dronefpgabasedarchitecture-pizza/portapack/README.md

portapack
=========

Portable software-defined radio add-on for HackRF Jawbreaker
