dronefpgabasedarchitecture-pizza/portapack/portapack_hackrf/hardware/portapack_hackrf_one/portapack_hackrf_one.pdf

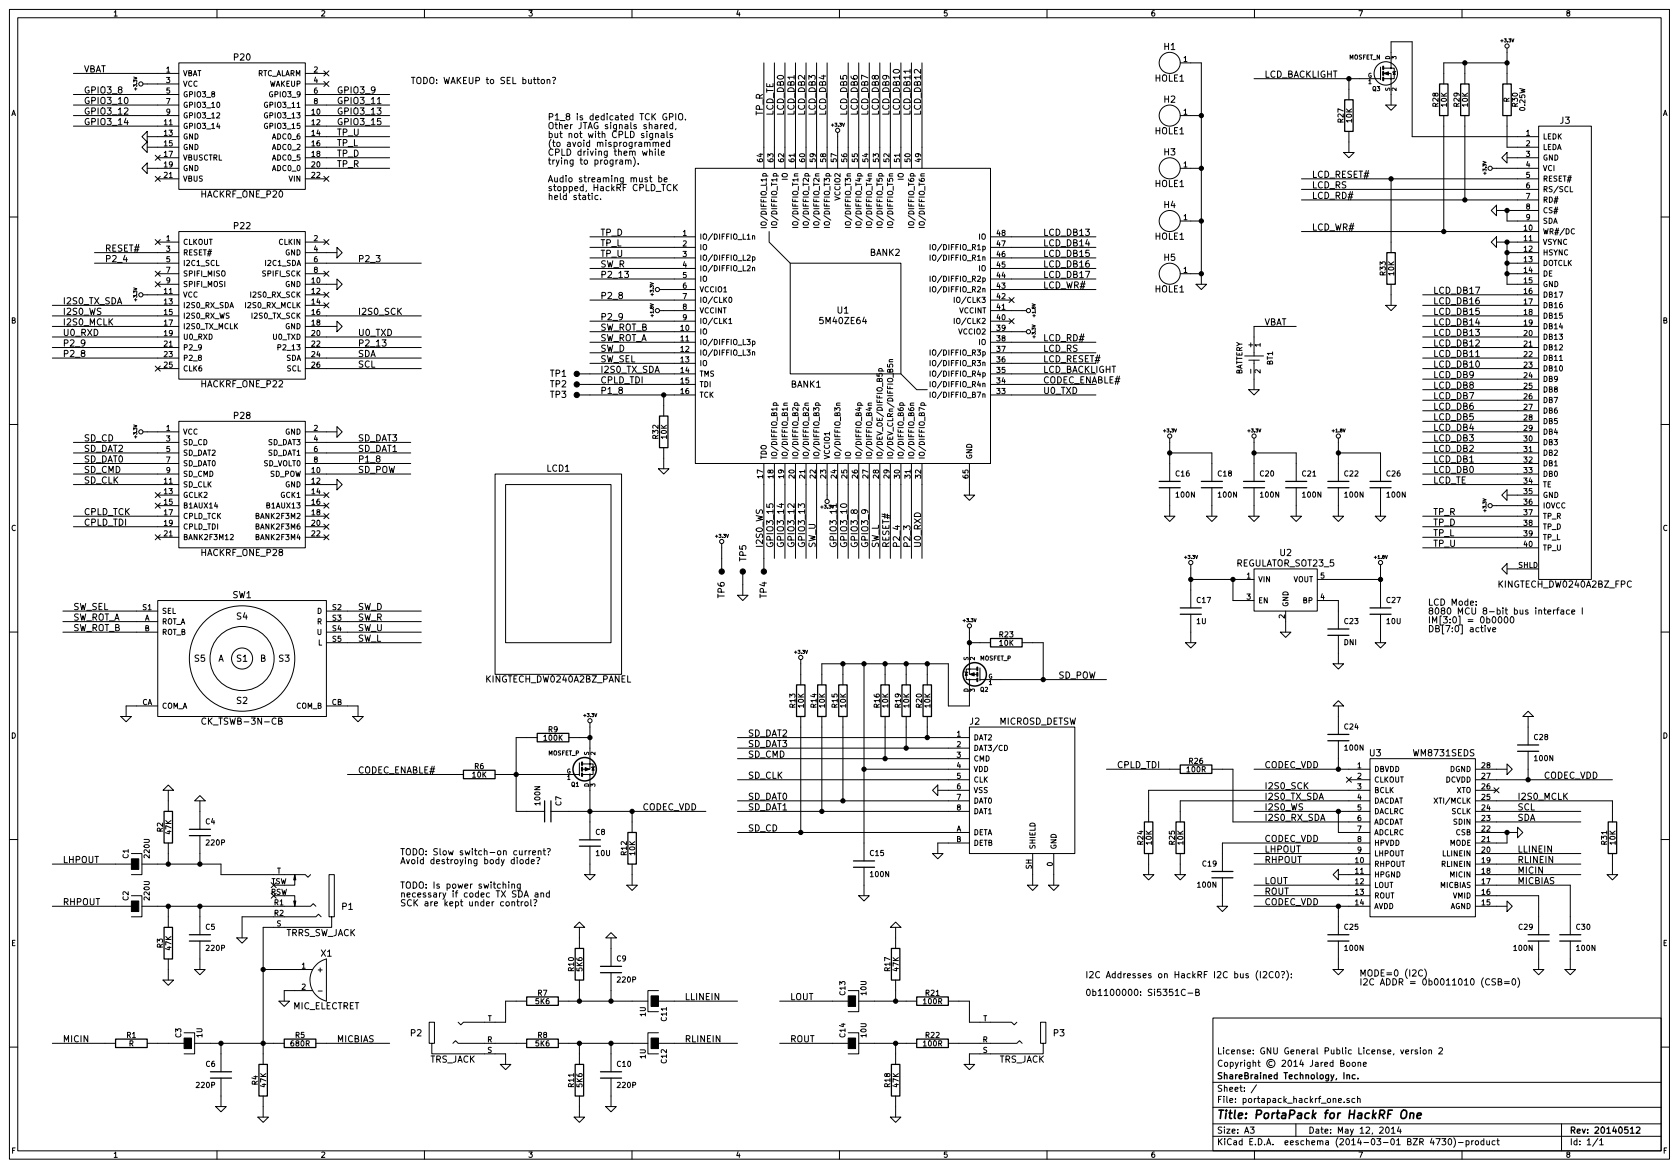
[picture p1: page 1]
