dronefpgabasedarchitecture-pizza/portapack/portapack_hackrf/hardware/portapack_hackrf_one/portapack_hackrf_one.kicad_pcb

## KiCad design portapack_hackrf/hardware/portapack_hackrf_one/portapack_hackrf_one.kicad_pcb (2014-05-29)

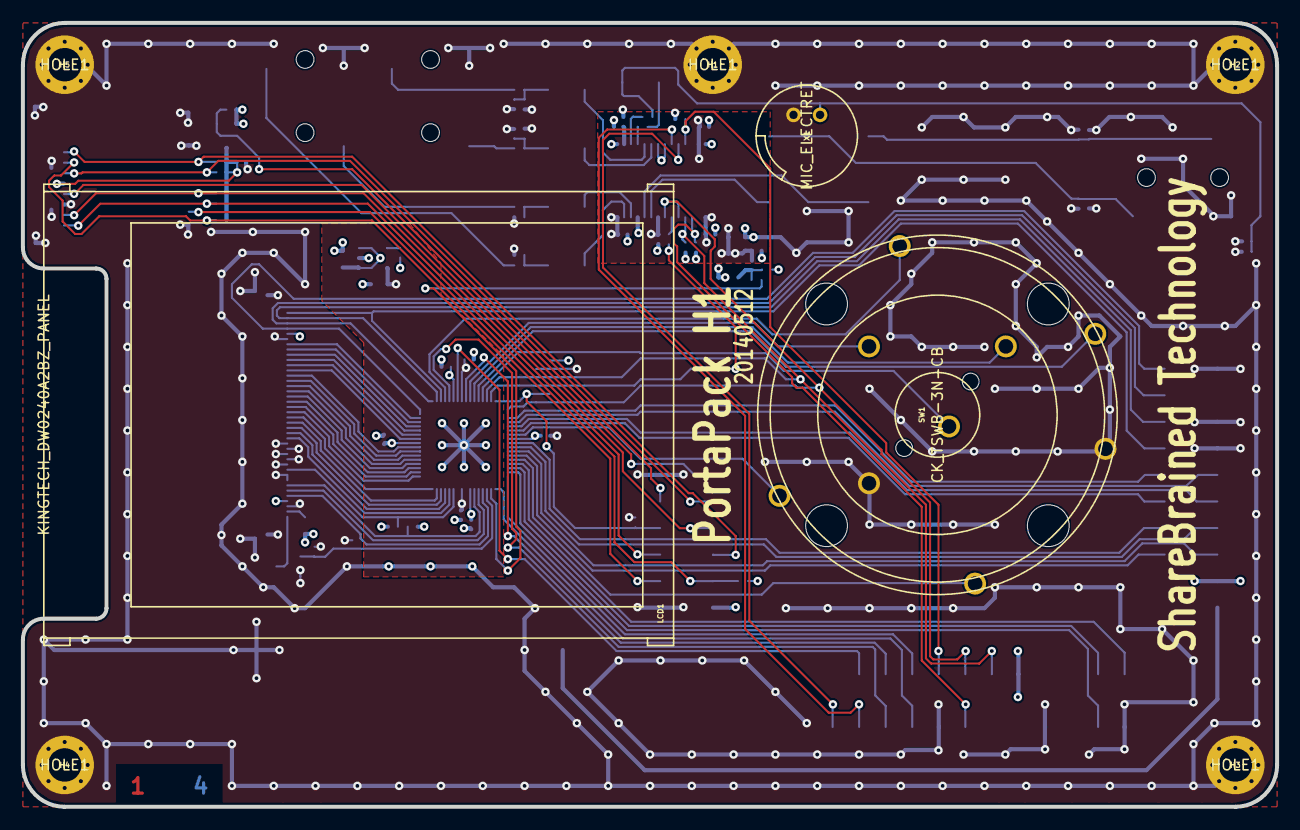
[picture p2: board portapack_hackrf_one.kicad_pcb from above]

Board: 4 copper layers, 120.0 x 75.0 mm, 92 parts (0 on the bottom side), 100 nets.

Parts:
BT1: BATTERY; MPD_BU2032SM-BT-G
C1, C2: 220U; IPC_CAPAE830X620N
C3, C11, C12: 1U; IPC_CAPAE430X540N
C4, C5, C6, C9, C10: 220P; IPC_CAPC1005X55N
C7, C15, C16, C18, C19, C20, C21, C22, C24, C25, C26, C28, C29, C30: 100N; IPC_CAPC1005X55N
C8, C27: 10U; IPC_CAPC1608X95N
C13, C14: 10U; IPC_CAPAE430X540N
C17: 1U; IPC_CAPC1608X95N
C23: DNI; IPC_CAPC1005X55N
H1, H2, H3, H4, H5: HOLE1; HOLE_3200UM_VIAS
J2: MICROSD_DETSW; ALPS_SCHA4B0400
J3: KINGTECH_DW0240A2BZ_FPC; MOLEX_54132-40XX_LR
LCD1: KINGTECH_DW0240A2BZ_PANEL
P1: TRRS_SW_JACK; CUI_SJ-43516-SMT
P2, P3: TRS_JACK; CUI_SJ-3524-SMT
P20: HACKRF_ONE_P20; HEADER_11X2_REV_SM_254
P22: HACKRF_ONE_P22; HEADER_13X2_REV_SM_254
P28: HACKRF_ONE_P28; HEADER_11X2_REV_SM_254
Q1, Q2: MOSFET_P; IPC_SOT95P240X110-3N
Q3: MOSFET_N; IPC_SOT95P230X110-3N
R1: R; IPC_RESC1005X40N
R2, R3, R4, R17, R18: 47K; IPC_RESC1005X40N
R5: 680R; IPC_RESC1005X40N
R6, R12, R13, R14, R15, R16, R19, R20, R23, R24, R25, R27, R28, R29, R31, R32, R33: 10K; IPC_RESC1005X40N
R7, R8, R10, R11: 5K6; IPC_RESC1005X40N
R9: 100K; IPC_RESC1005X40N
R21, R22, R26: 100R; IPC_RESC1005X40N
R30: R; IPC_RESC1608X55N
SW1: CK_TSWB-3N-CB; CK_TSWB-3N-CB222_LFS
TP1, TP2, TP3, TP4, TP5, TP6: TP; TP_1MM
U1: 5M40ZE64; IPC_QFP40P900X900X120-65N
U2: REGULATOR_SOT23_5; IPC_SOT95P280X110-5N
U3: WM8731SEDS; IPC_SOP65P780X200-28N
X1: MIC_ELECTRET; CUI_CMA-4544PF-W

Connections:
+1.8V: C22.1, C26.1, C27.1, U1.8, U1.41, U2.5
+3.3V: C16.1, C17.1, C18.1, C20.1, C21.1, J3.4, J3.36, P20.3, P22.11, P28.1, Q1.2, Q2.2, R9.1, R13.1, R23.1, R28.1, R29.1, R30.1, TP6.1, U1.6, U1.23, U1.39, U1.57, U2.1, U2.3
/CODEC_ENABLE#: R6.2, U1.34
/CODEC_VDD: C7.1, C8.1, C19.1, C24.2, C25.1, C28.2, Q1.3, R12.1, U3.1, U3.8, U3.14, U3.27
/CPLD_TDI: P28.19, R26.2, TP2.1, U1.15
/GPIO3_8: P20.5, U1.26
/GPIO3_9: P20.6, U1.27
/GPIO3_10: P20.7, U1.25
/GPIO3_11: P20.8, U1.24
/GPIO3_12: P20.9, U1.20
/GPIO3_13: P20.10, U1.21
/GPIO3_14: P20.11, U1.19
/GPIO3_15: P20.12, U1.18
/I2S0_MCLK: P22.17, R31.1, U3.25
/I2S0_RX_SDA: R26.1, U3.6
/I2S0_SCK: P22.16, R24.1, U3.3
/I2S0_TX_SDA: P22.13, R25.1, TP1.1, U1.14, U3.4
/I2S0_WS: P22.15, TP4.1, U1.17, U3.5, U3.7
/LCD_BACKLIGHT: Q3.1, R27.1, U1.35
/LCD_DB0: J3.33, U1.62
/LCD_DB1: J3.32, U1.61
/LCD_DB2: J3.31, U1.60
/LCD_DB3: J3.30, U1.59
/LCD_DB4: J3.29, U1.58
/LCD_DB5: J3.28, U1.56
/LCD_DB6: J3.27, U1.55
/LCD_DB7: J3.26, U1.54
/LCD_DB8: J3.25, U1.53
/LCD_DB9: J3.24, U1.52
/LCD_DB10: J3.23, U1.51
/LCD_DB11: J3.22, U1.50
/LCD_DB12: J3.21, U1.49
/LCD_DB13: J3.20, U1.48
/LCD_DB14: J3.19, U1.47
/LCD_DB15: J3.18, U1.46
/LCD_DB16: J3.17, U1.45
/LCD_DB17: J3.16, U1.44
/LCD_RD#: J3.7, R29.2, U1.38
/LCD_RESET#: J3.5, R33.1, U1.36
/LCD_RS: J3.6, U1.37
/LCD_TE: J3.34, U1.63
/LCD_WR#: J3.10, R28.2, U1.43
/LHPOUT: C1.1, U3.9
/LLINEIN: C11.1, U3.20
/LOUT: C13.1, U3.12
/MICBIAS: C30.1, R5.1, U3.17
/MICIN: R1.2, U3.18
/P1_8: P28.8, R32.1, TP3.1, U1.16
/P2_3: P22.6, U1.31
/P2_4: P22.5, U1.30
/P2_8: P22.23, U1.7
/P2_9: P22.21, U1.9
/P2_13: P22.22, U1.5
/RESET#: P22.3, U1.29
/RHPOUT: C2.1, U3.10
/RLINEIN: C12.1, U3.19
/ROUT: C14.1, U3.13
/SCL: P22.26, U3.24
/SDA: P22.24, U3.23
/SD_CD: J2.A, P28.3, R13.2
/SD_CLK: J2.5, P28.11
/SD_CMD: J2.3, P28.9, R16.2
/SD_DAT0: J2.7, P28.7, R15.2
/SD_DAT1: J2.8, P28.6, R14.2
/SD_DAT2: J2.1, P28.5, R20.2
/SD_DAT3: J2.2, P28.4, R19.2
/SD_POW: P28.10, Q2.1, R23.2
/SW_D: SW1.S2, U1.12
/SW_L: SW1.S5, U1.28
/SW_R: SW1.S3, U1.4
/SW_ROT_A: SW1.A, U1.11
/SW_ROT_B: SW1.B, U1.10
/SW_SEL: SW1.S1, U1.13
/SW_U: SW1.S4, U1.22
/TP_D: J3.38, P20.18, U1.1
/TP_L: J3.39, P20.16, U1.2
/TP_R: J3.37, P20.20, U1.64
/TP_U: J3.40, P20.14, U1.3
/U0_RXD: P22.19, U1.32
/U0_TXD: P22.20, U1.33
/VBAT: BT1.1, P20.1
GND: BT1.2, C4.1, C5.2, C6.2, C8.2, C9.1, C10.2, C15.2, C16.2, C17.2, C18.2, C19.2, C20.2, C21.2, C22.2, C23.2, C24.1, C25.2, C26.2, C27.2, C28.1, C29.2, C30.2, H1.1, H2.1, H3.1, H4.1, H5.1, J2.0, J2.6, J2.B, J2.SH, J3.3, J3.8, J3.9, J3.11, J3.12, J3.13, J3.14, J3.15, J3.35, J3.SHLD, P1.4, P2.1, P3.1, P20.13, P20.15, P20.19, P22.4, P22.10, P22.18, P28.2, P28.12, Q3.2, R2.1, R3.2, R4.2, R10.1, R11.2, R12.2, R17.1, R18.2, R24.2, R25.2, R27.2, R31.2, R32.2, R33.2, SW1.CA, SW1.CB, TP5.1, U1.65, U2.2, U3.11, U3.15, U3.21, U3.22, U3.28, X1.2
unnamed: C1.2, C4.2, P1.2, R2.2
unnamed: C2.2, C5.1, P1.3, R3.1
unnamed: C3.1, R1.1
unnamed: C3.2, C6.1, P1.1, R4.1, R5.2, X1.1
unnamed: C7.2, Q1.1, R6.1, R9.2
unnamed: C10.1, C12.2, R8.1, R11.1
unnamed: C9.2, C11.2, R7.1, R10.2
unnamed: C13.2, R17.2, R21.2
unnamed: C14.2, R18.1, R22.2
unnamed: C15.1, J2.4, Q2.3, R14.1, R15.1, R16.1, R19.1, R20.1
unnamed: C23.1, U2.4
unnamed: C29.1, U3.16
unnamed: J3.1, Q3.3
unnamed: J3.2, R30.2
unnamed: P2.2, R7.2
unnamed: P2.3, R8.2
unnamed: P3.2, R21.1
unnamed: P3.3, R22.1
