dronefpgabasedarchitecture-pizza/portapack/portapack_hackrf/hardware/portapack_jawbreaker/portapack_jawbreaker.kicad_pcb

## KiCad design portapack_hackrf/hardware/portapack_jawbreaker/portapack_jawbreaker.kicad_pcb (2014-01-01)

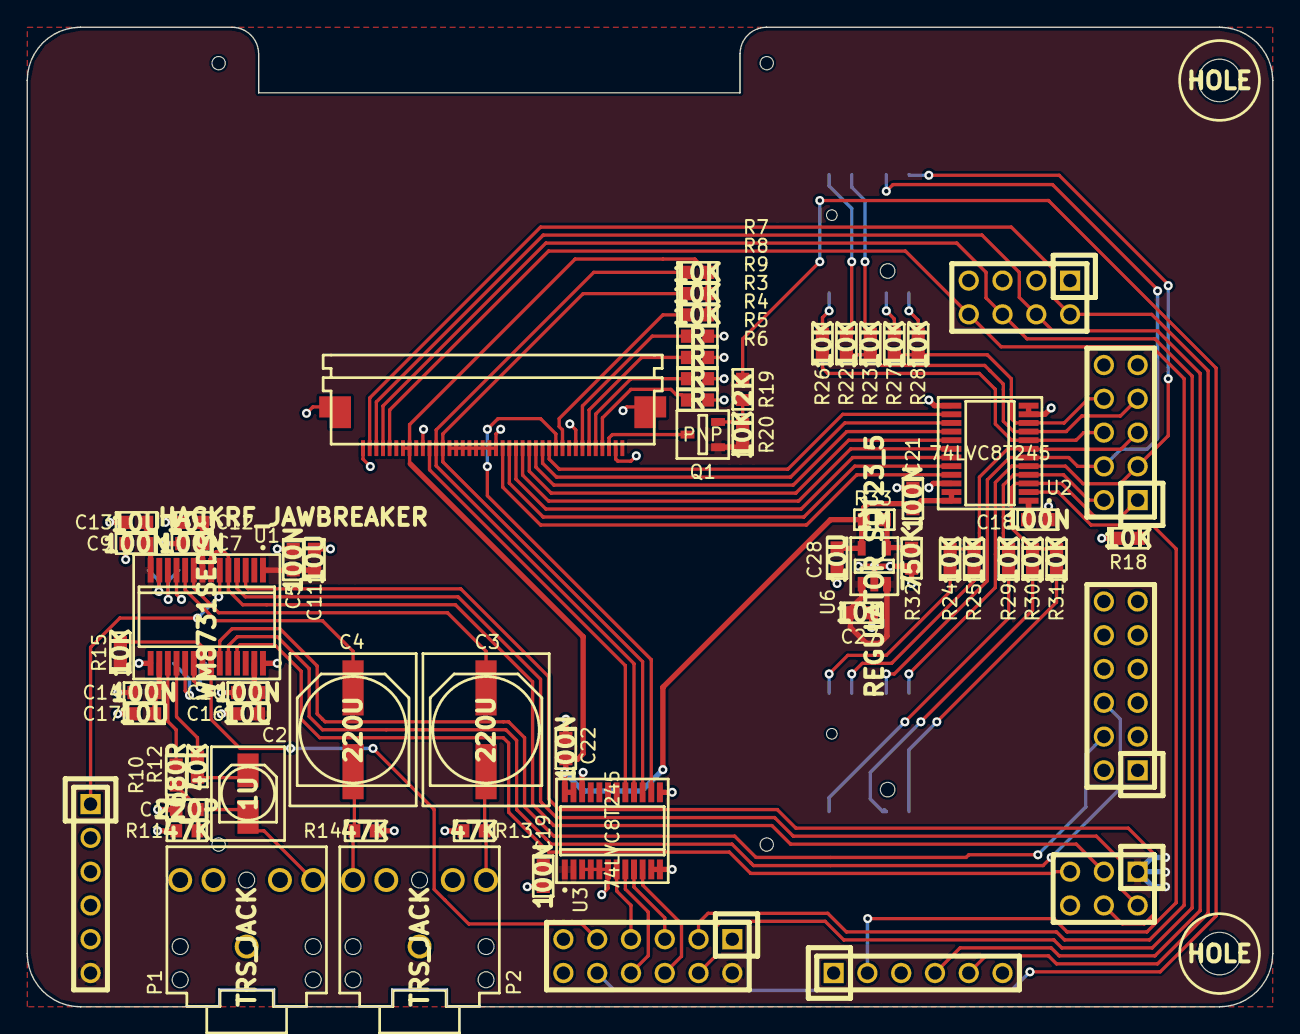
[picture p3: board portapack_jawbreaker.kicad_pcb from above]

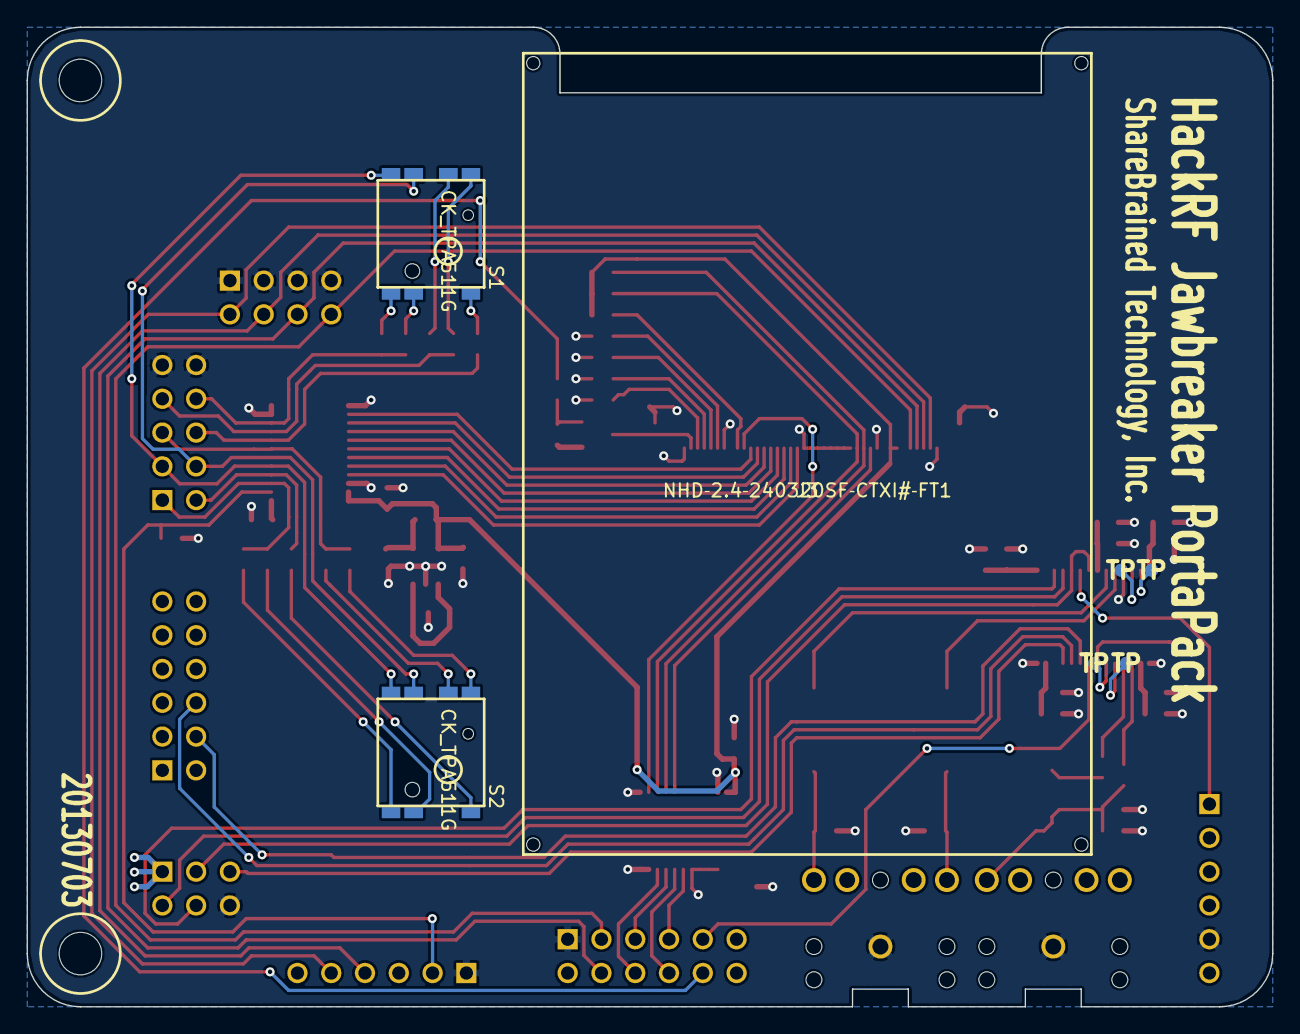
[picture p4: board portapack_jawbreaker.kicad_pcb from below]

Board: 2 copper layers, 93.7 x 73.7 mm, 65 parts (7 on the bottom side), 73 nets.

Parts:
C1: 220P; IPC_CAPC1608X90N
C2: 1U; IPC_CAPAE430X540N
C3, C4: 220U; IPC_CAPAE830X620N
C5, C7, C9, C10, C14, C18, C19, C21, C22: 100N; IPC_CAPC1608X90N
C11, C12, C13, C16, C17, C27, C28: 10U; IPC_CAPC1608X95N
H1, H2: HOLE; HOLE_3P2MM
J1: HACKRF_JAWBREAKER; HACKRF_JAWBREAKER_SHIELD
J3: NHD‐2.4‐240320SF‐CTXI#‐FT1; NHD-2.4-240320SF-CTXI-FT1
P1, P2: TRS_JACK; CUI_SJ1-352XN
Q1: PNP; IPC_SOT95P237X111-3N
R3, R4, R5, R6: R; IPC_RESC1608X55N
R7, R8, R9, R15, R18, R20, R22, R23, R24, R25, R26, R27, R28, R29, R30, R31: 10K; IPC_RESC1608X55N
R10: 680R; IPC_RESC1608X55N
R11, R13, R14: 47K; IPC_RESC1608X55N
R12: 40K; IPC_RESC1608X55N
R19: 2K; IPC_RESC1608X55N
R32: 750K; IPC_RESC1608X55N
R33: 1M; IPC_RESC1608X55N
S1, S2: CK_TPA511G
TP1, TP2, TP3, TP4: TP; TP_1MM
U1: WM8731SEDS; IPC_SOP65P780X200-28N
U2, U3: 74LVC8T245; IPC_SOP65P640X120-24N
U6: REGULATOR_SOT23_5; IPC_SOT95P280X110-5N

Connections:
3V3: C5.1, C7.1, C9.1, C10.1, C11.1, C12.1, C13.1, C16.1, C18.1, C19.1, C27.1, J1.2201, J1.2802, J1.2906, Q1.1, R15.2, R20.2, U1.1, U1.8, U1.14, U1.27, U2.1, U3.1, U3.2, U6.1, U6.3
/GPIO0: J1.2001, R30.2, R31.2, U2.3
/GPIO0_S: J3.22, U2.21
/GPIO1: J1.2002, R29.2, U2.4
/GPIO1_S: J3.23, U2.20
/GPIO2: J1.2003, S1.1, S2.1, U2.5
/GPIO2_S: J3.24, U2.19
/GPIO3: J1.2004, S1.2, S2.2, U2.6
/GPIO3_S: J3.25, U2.18
/GPIO4: J1.2005, R24.1, R25.1, U2.7
/GPIO4_S: J3.26, U2.17
/GPIO5: J1.2006, R26.2, U2.8
/GPIO5_S: J3.27, U2.16
/GPIO6: J1.2007, R22.1, R23.1, U2.9
/GPIO6_S: J3.28, U2.15
/GPIO7: J1.2008, R27.2, R28.2, U2.10
/GPIO7_S: J3.29, U2.14
/GPIO_DIR: J1.2502, R18.2, U2.2
/I2S0_RX_SDA: J1.2901, U1.6
/I2S0_TX_MCLK: J1.2205, U1.25
/I2S0_TX_SCK: J1.2204, U1.3
/I2S0_TX_SDA: J1.2202, U1.4
/I2S0_TX_WS: J1.2203, U1.5, U1.7
/LHPOUT: C3.1, U1.9
/MICBIAS: R10.2, U1.17
/MICIN: R12.2, U1.18
/RD#: J1.2805, U3.9
/RD#_S: J3.13, R8.1, U3.15
/RDY#: J1.2810, R19.1
/RESET#: J1.2806, U3.10
/RESET#_S: J3.30, U3.14
/RHPOUT: C4.1, U1.10
/RS: J1.2807, U3.7
/RS_S: J3.11, U3.17
/SPI_CS#_CODEC: J1.2809, U1.22
/SPI_MOSI: J1.1904, U1.23
/SPI_SCK: J1.1906, U1.24
/TS_X+: J1.2104, J1.2504, J3.3
/TS_X-: J1.2108, J1.2803, J3.5
/TS_Y+: J1.2106, J1.2804, J3.4
/TS_Y-: J1.2102, J1.2505, J3.2
/VCC_IO: C21.1, C22.1, C28.1, J3.7, J3.8, R7.2, R8.2, R9.2, R33.2, U2.23, U2.24, U3.23, U3.24, U6.5
/WR#: J1.2808, U3.8
/WR#_S: J3.12, R7.1, U3.16
GND: C1.2, C5.2, C7.2, C9.2, C10.2, C11.2, C12.2, C13.2, C14.2, C16.2, C17.2, C18.2, C19.2, C21.2, C22.2, C27.2, C28.2, J1.2009, J1.2010, J1.2101, J1.2103, J1.2105, J1.2107, J1.2206, J1.2501, J1.2801, J1.2905, J3.1, J3.10, J3.14, J3.15, J3.16, J3.17, J3.18, J3.19, J3.20, J3.21, J3.33, J3.39, J3.SHLD, P1.1, P2.1, R3.1, R4.1, R5.1, R6.1, R11.1, R13.2, R14.1, R18.1, R32.1, U1.11, U1.15, U1.28, U2.11, U2.12, U2.13, U2.22, U3.3, U3.4, U3.5, U3.6, U3.11, U3.12, U3.13, U3.22, U6.2
unnamed: TP3.1, U1.20
unnamed: TP1.1, U1.12
unnamed: TP2.1, U1.13
unnamed: TP4.1, U1.19
unnamed: R28.1, S1.4
unnamed: C1.1, C2.2, P1.2, R10.1, R11.2
unnamed: C2.1, R12.1
unnamed: C3.2, P2.2, R13.1
unnamed: R15.1, U1.21
unnamed: C4.2, P2.3, R14.2
unnamed: J3.31, R9.1
unnamed: C14.1, C17.1, U1.16
unnamed: Q1.2, R19.2, R20.1
unnamed: R31.1, S2.4
unnamed: J3.38, Q1.3
unnamed: R25.2, S2.6
unnamed: R30.1, S2.3
unnamed: R24.2, S2.7
unnamed: R26.1, S1.5
unnamed: R29.1, S2.5
unnamed: R22.2, S1.7
unnamed: R23.2, S1.6
unnamed: R27.1, S1.3
unnamed: R32.2, R33.1, U6.4
unnamed: J3.35, R4.2
unnamed: J3.36, R5.2
unnamed: J3.37, R6.2
unnamed: J3.34, R3.2
