dronefpgabasedarchitecture-pizza/portapack/(commit log)

2014-01-01 Committed 20130703_1525 schematic/PCB/Gerbers of Jawbreaker PortaPack.
    [portapack_jawbreaker-B_Cu.gbl, portapack_jawbreaker-B_Mask.gbs, portapack_jawbreaker-B_SilkS.gbo, portapack_jawbreaker-Edge_Cuts.gbr, portapack_jawbreaker-F_Cu.gtl, portapack_jawbreaker-F_Mask.gts, portapack_jawbreaker-F_SilkS.gto, portapack_jawbreaker.drl]
2014-01-01 Fix breakage from incomplete change in decimation and demodulation API arguments.
    [decimate_test.c, demodulate.c, demodulate.h]
2014-01-01 Document WBFM audio filter/decimator.
2014-01-01 Add TODO to implement FM broadcast channel filter for improved adjacent channel rejection.
2014-01-01 Quick and dirty NBFM receive support. Receives NOAA WX radio well, but could certainly use a channel filter and other tweaks.
2014-01-01 Remove a bit more dead code. I'm committed to using the fixed-point atan2() at this point.
    [demodulate.c]
2014-01-01 Remove gr_fast_atan2f from code. TODO to implement FM demodulation gain correction.
    [demodulate.c]
2014-01-01 Generalize FIR real filter a bit, extract filter taps into application code.
2014-01-01 Massive rework of LCD layer, refactored a bunch of stuff.
    [lcd.c, lcd.h, lcd_loop.c]
2014-01-02 Fix LCD font pixel scan order.
    [lcd.c]
2014-01-02 Add function to compute string pixel width based on current font.
2014-01-02 Nuke residual spectrum analyzer code that will need serious upgrading to work with new frameworks.
2014-01-02 Add bigger, 8x16 fixed font, make the default.
    [lcd.c]
2014-01-02 Relocate baseband sample buffers to make a 32K block for the M0. Relocate shared memory items to new M0 region.
2014-01-02 Create device_state structure to share data between M4 and M0 processors.
2014-01-02 Re-plumb application code to use device_state values.
2014-01-02 Temporary delay() fix to slow down main loop so that buttons and switches don't react/repeat way too fast...
2014-01-02 Rework LCD data to take use of the new font, field rendering, and device state.
    [lcd_loop.c]
2014-01-02 Add and use LCD color invert function.
    [lcd.c, lcd.h, lcd_loop.c]
2014-01-02 Fix MHz field display to drop <kHz digits.
    [lcd_loop.c]
2014-01-02 Fix percent field display to show only 1/10% precision.
    [lcd_loop.c]
2014-01-02 Missing argument in draw_cycles().
    [lcd_loop.c]
2014-01-02 Add LCD refresh synchronization and frame counter (mostly for validation).
2014-01-02 Remove LED toggle in GPDMA ISR.
2014-01-03 Add ARM intrinsics for SEV, WFE, WFI instructions.
2014-01-03 Enable M0APPTXEVENT interrupt on M4. Handle M0 interrupt on M4, checking value to execute UI commands from M0. Move the joysticks handler to the M0. Replace M4 main loop with a WFE (processor sleep a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
    [lcd_loop.c, lcd_loop.h, portapack.c]
2014-01-04 Tweak event and sleep ARM intrinsics to indicate they change memory.
2014-01-04 Add isb, dsb, dmb ARM intrinsics.
2014-01-04 Add Linux kfifo implementation, rejiggered to work on embedded platforms without user/kernel memory distinction, memory alloc/free, DMA support, etc. Also bring in required bits from Linux #include h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
2014-01-04 Remove min() definition, replace with Linux min() in linux_stuff.h.
    [lcd_loop.c]
2014-01-04 Adapt UI and DSP code to use IPC for RF/DSP operations. Rework set_frequency() to return success from set_freq(), not do its own frequency range test..
    [lcd_loop.c, lcd_loop.h, portapack.c]
2014-01-04 Fix lcd_dir_idle() to not drive the data bus at all. Previously, the LCD was driving the bus -- same as "read" mode.
    [lcd.c]
2014-01-04 Un-expose switches_state, make it local to the UI code.
2014-01-04 Simple debouncing and edge-detection of switches, so that UI operates and human speed. ;-)
2014-01-05 Fix copy-and-paste oops preventing right navigation from working.
    [lcd_loop.c]
2014-01-06 Rename UI frame counter, extract from function.
2014-01-06 Separate switch events into three separate variables: switch on, switch transition to on, switch transition to off.
2014-01-06 Simple up/down key repeat for changing values in UI. Needs refactoring -- too much repeated code. And maybe a field-specific increment rate handler, so the frequency field repeat magnitude can accele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
    [lcd_loop.c]
2014-01-06 Create a struct for UI switch state, refactor switch repeat code.
2014-01-07 Alter data provided to switch/UI event handlers to indicate the count of repeats, for implementing accelerating repeats. Created a somewhat awkward accelerating frequency behavior.
2014-01-10 Missing code to load/start M0 from M4 core. (Moved from HackRF to PortaPack.)
    [m0_startup.c, m0_startup.h, portapack.c]
2014-05-29 Initial build of the PortaPack for HackRF One.
    [portapack_hackrf_one.kicad_pcb, portapack_hackrf_one.sch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]
